kakudo415/4421/README.md

# 4421

| Number | Meaning  |
| -----: | :--- |
| 44 | 44 Keys  |
| 2 | Separate |
| 1 | Number 1 |
