kakudo415/4421/pcb/schematic.pdf

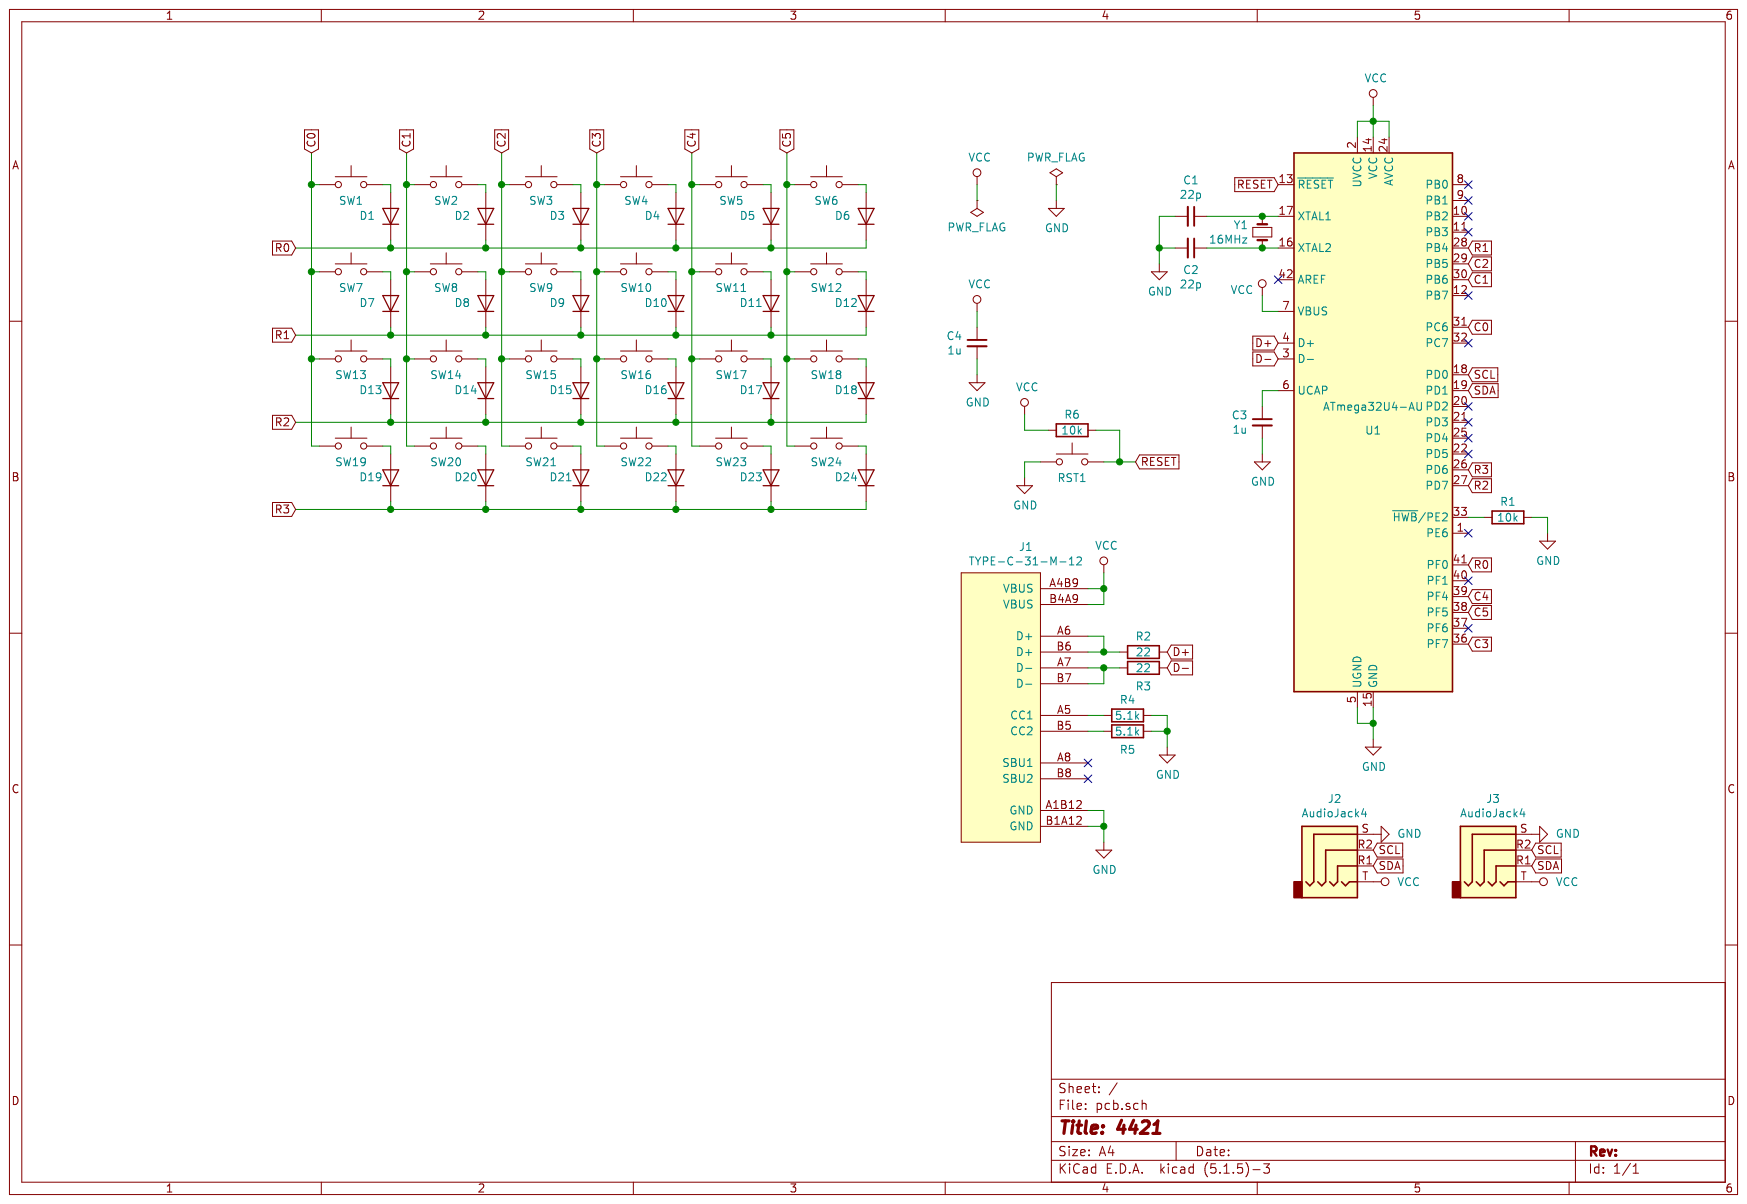
[picture p1: page 1]
