kakudo415/4421/pcb/pcb.kicad_pcb

## KiCad design pcb/pcb.kicad_pcb (2020-08-24)

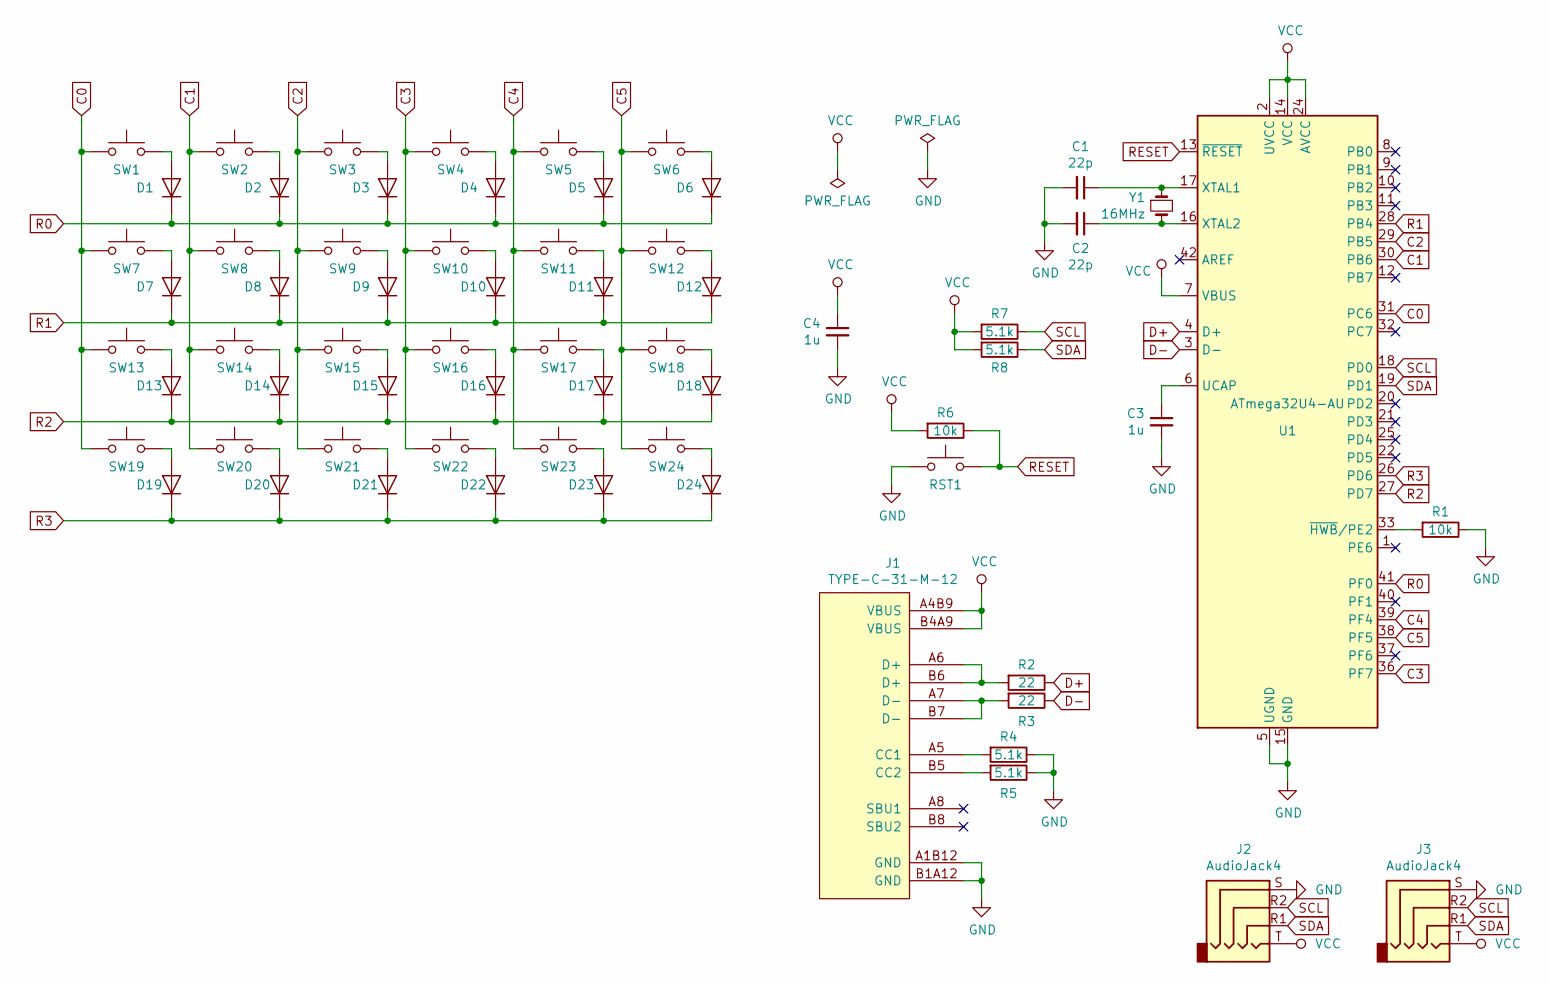
[picture p2: schematic pcb.sch, 4421]

Parts:
C1, C2: 22p; 2012M
C3, C4: 1u; 2012M
D1, D2, D3, D4, D5, D6, D7, D8, D9, D10, D11, D12, D13, D14, D15, D16, D17, D18, D19, D20, D21, D22, D23, D24: D; SOD123
J1: TYPE-C-31-M-12
J2, J3: AudioJack4; MJ-4PP-9
R1, R6: 10k; 2012M
R2, R3: 22; 2012M
R4, R5, R7, R8: 5.1k; 2012M
RST1: SW_Push; SW_SPST_TL3342
SW1, SW2, SW3, SW4, SW5, SW6, SW7, SW8, SW9, SW10, SW11, SW12, SW13, SW14, SW15, SW16, SW17, SW18, SW19, SW20, SW21, SW22, SW23, SW24: SW_Push; 1u
U1: ATmega32U4-AU; TQFP44
Y1: 16MHz; Crystal-HC-49-S

Connections:
C0: SW1.1, SW7.1, SW13.1, SW19.1, U1.31 (PC6)
C1: SW2.1, SW8.1, SW14.1, SW20.1, U1.30 (PB6)
C2: SW3.1, SW9.1, SW15.1, SW21.1, U1.29 (PB5)
C3: SW4.1, SW10.1, SW16.1, SW22.1, U1.36 (PF7)
C4: SW5.1, SW11.1, SW17.1, SW23.1, U1.39 (PF4)
C5: SW6.1, SW12.1, SW18.1, SW24.1, U1.38 (PF5)
D+: R2.1, U1.4 (D+)
D-: R3.1, U1.3 (D-)
GND: C1.2, C2.2, C3.2, C4.2, J1.A1B12 (GND), J1.B1A12 (GND), J2.S, J3.S, R1.1, R4.1, R5.1, RST1.1, U1.5 (UGND), U1.15 (GND), U1.23 (GND), U1.35 (GND), U1.43 (GND)
unnamed: C1.1, U1.17 (XTAL1), Y1.1
unnamed: C2.1, U1.16 (XTAL2), Y1.2
unnamed: C3.1, U1.6 (UCAP)
unnamed: D1.2 (A), SW1.2
unnamed: D2.2 (A), SW2.2
unnamed: D3.2 (A), SW3.2
unnamed: D4.2 (A), SW4.2
unnamed: D5.2 (A), SW5.2
unnamed: D6.2 (A), SW6.2
unnamed: D7.2 (A), SW7.2
unnamed: D8.2 (A), SW8.2
unnamed: D9.2 (A), SW9.2
unnamed: D10.2 (A), SW10.2
unnamed: D11.2 (A), SW11.2
unnamed: D12.2 (A), SW12.2
unnamed: D13.2 (A), SW13.2
unnamed: D14.2 (A), SW14.2
unnamed: D15.2 (A), SW15.2
unnamed: D16.2 (A), SW16.2
unnamed: D17.2 (A), SW17.2
unnamed: D18.2 (A), SW18.2
unnamed: D19.2 (A), SW19.2
unnamed: D20.2 (A), SW20.2
unnamed: D21.2 (A), SW21.2
unnamed: D22.2 (A), SW22.2
unnamed: D23.2 (A), SW23.2
unnamed: D24.2 (A), SW24.2
unnamed: J1.A5 (CC1), R4.2
unnamed: J1.A6 (D+), J1.B6 (D+), R2.2
unnamed: J1.A7 (D-), J1.B7 (D-), R3.2
unnamed: J1.B5 (CC2), R5.2
unnamed: R1.2, U1.33 (~HWB~/PE2)
R0: D1.1 (K), D2.1 (K), D3.1 (K), D4.1 (K), D5.1 (K), D6.1 (K), U1.41 (PF0)
R1: D7.1 (K), D8.1 (K), D9.1 (K), D10.1 (K), D11.1 (K), D12.1 (K), U1.28 (PB4)
R2: D13.1 (K), D14.1 (K), D15.1 (K), D16.1 (K), D17.1 (K), D18.1 (K), U1.27 (PD7)
R3: D19.1 (K), D20.1 (K), D21.1 (K), D22.1 (K), D23.1 (K), D24.1 (K), U1.26 (PD6)
RESET: R6.1, RST1.2, U1.13 (~RESET)
SCL: J2.R2, J3.R2, R7.1, U1.18 (PD0)
SDA: J2.R1, J3.R1, R8.1, U1.19 (PD1)
VCC: C4.1, J1.A4B9 (VBUS), J1.B4A9 (VBUS), J2.T, J3.T, R6.2, R7.2, R8.2, U1.2 (UVCC), U1.7 (VBUS), U1.14 (VCC), U1.24 (AVCC), U1.34 (VCC), U1.44 (AVCC)

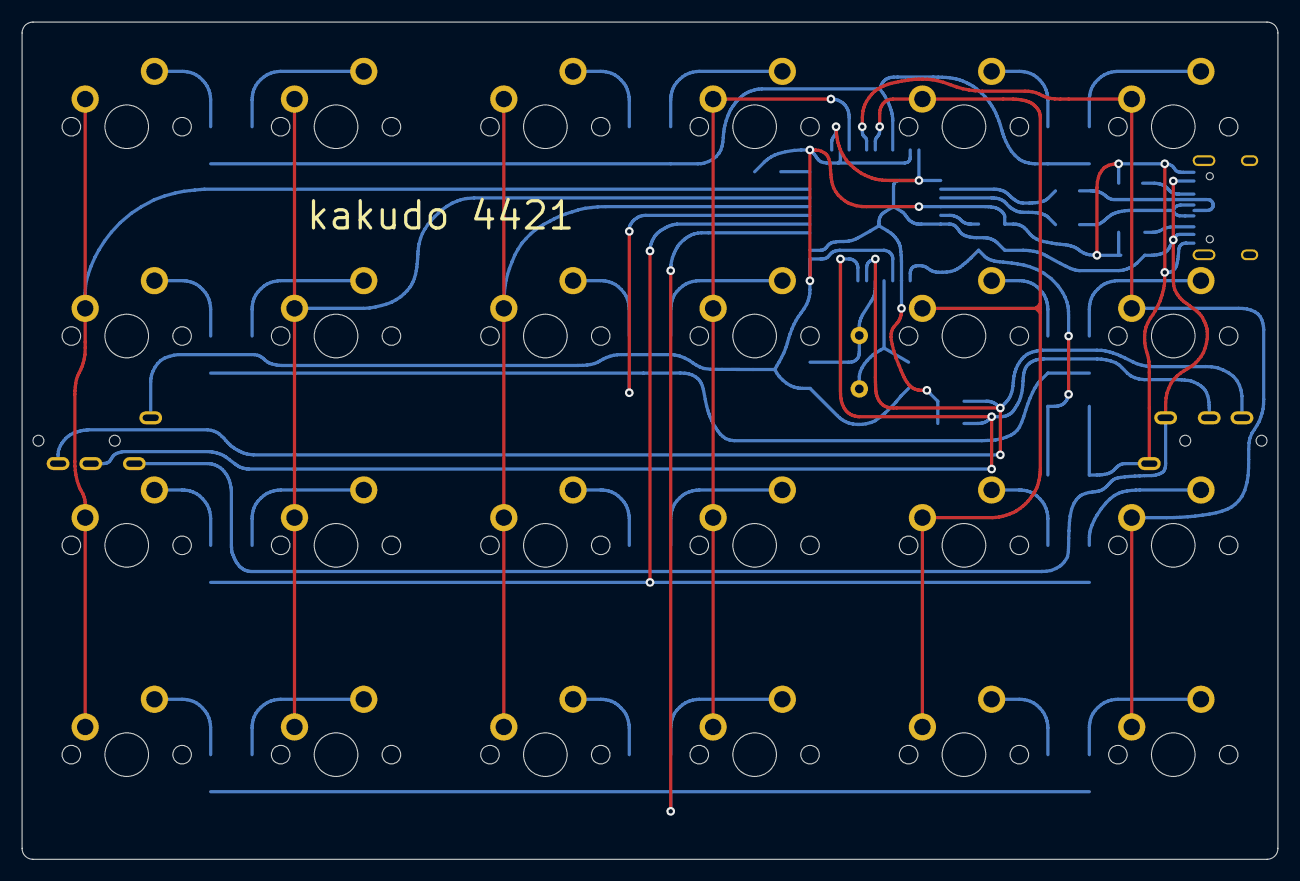
[picture p3: board pcb.kicad_pcb from above]

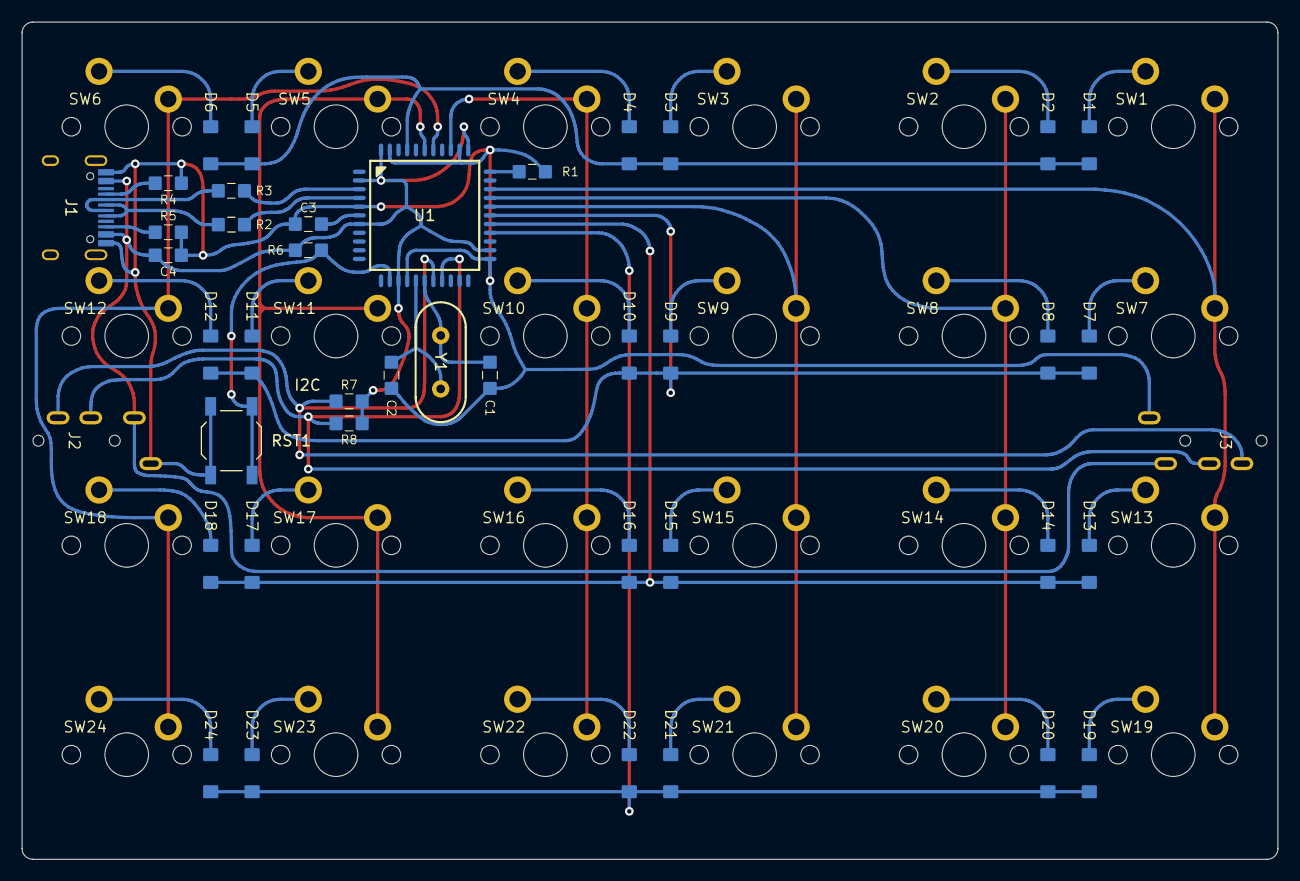
[picture p4: board pcb.kicad_pcb from below]

Board: 2 copper layers, 115.2 x 76.8 mm, 66 parts (41 on the bottom side), 49 nets.
