kakudo415/4421/(commit log)

2020-06-24 pcb initialize
    [pcb.kicad_pcb, pcb.sch]
2020-06-26 + outline
    [case.scad]
2020-07-04 squarer design.
    [case.scad]
2020-07-05 bezier corner
    [case.scad]
2020-07-05 take out libraries w/ temporary continuous_corner
    [lib.scad]
2020-07-05 bezier corner -> continuous corner
    [case.scad]
2020-07-08 + continuous_corner (90degree only)
    [case.scad, lib.scad]
2020-07-08 clean continuous_corner()
    [lib.scad]
2020-07-19 upper case
    [case.scad]
2020-07-20 upper & lower cases
    [case.scad]
2020-07-20 both sides
    [case.scad]
2020-07-23 height -> 24mm
    [case.scad]
2020-07-23 schematic outline
    [pcb.kicad_pcb, pcb.sch]
2020-08-10 adjust footprint library to 4421
2020-08-10 parts align (without trrs jack)
    [pcb.kicad_pcb, pcb.sch]
2020-08-11 routing done
    [pcb.kicad_pcb, pcb.sch]
2020-08-11 routing with curve
    [pcb.kicad_pcb]
2020-08-11 same length usb routing
    [pcb.kicad_pcb]
2020-08-11 + side hole & + switch opener friendly key hole
    [case.scad]
2020-08-11 audio connector offset
    [case.scad, pcb.kicad_pcb]
2020-08-11 silk align
    [pcb.kicad_pcb]
2020-08-11 both side usb connector
    [case.scad]
2020-08-11 through screw hole
    [case.scad]
2020-08-12 routing beautify & product number
    [pcb.kicad_pcb]
2020-08-12 + gerber_to_order
2020-08-13 smd 2012 beautify
    [pcb.kicad_pcb]
2020-08-13 + reset button
    [pcb.kicad_pcb, pcb.sch]
2020-08-13 plot for jlcpcb
    [pcb.kicad_pcb]
2020-08-13 comment outed plate exporter
    [case.scad]
2020-08-14 key hole style rouded
    [case.scad, lib.scad]
2020-08-15 bigger plate holder & hexagon nuts
    [case.scad, lib.scad]
2020-08-15 coordinate simplified
    [case.scad]
2020-08-15 + schematic PDF
    [pcb.sch]
2020-08-19 USB-C receptacle hole circlize(?)
    [pcb.kicad_pcb]
2020-08-21 screw hole adjust
    [case.scad]
2020-08-22 change shape of nut hole
    [case.scad]
2020-08-24 + I2C pullup
    [pcb.kicad_pcb, pcb.sch]
2020-08-24 silk change
    [pcb.kicad_pcb]
2020-10-21 高さ修正
    [case.scad]
2020-10-21 キーの引っ掛かりを解消するための逃がし
    [case.scad]
